anujgite10-10/subthreshold-neuromorphic-lif-stdp/assets/layout_LIF.png

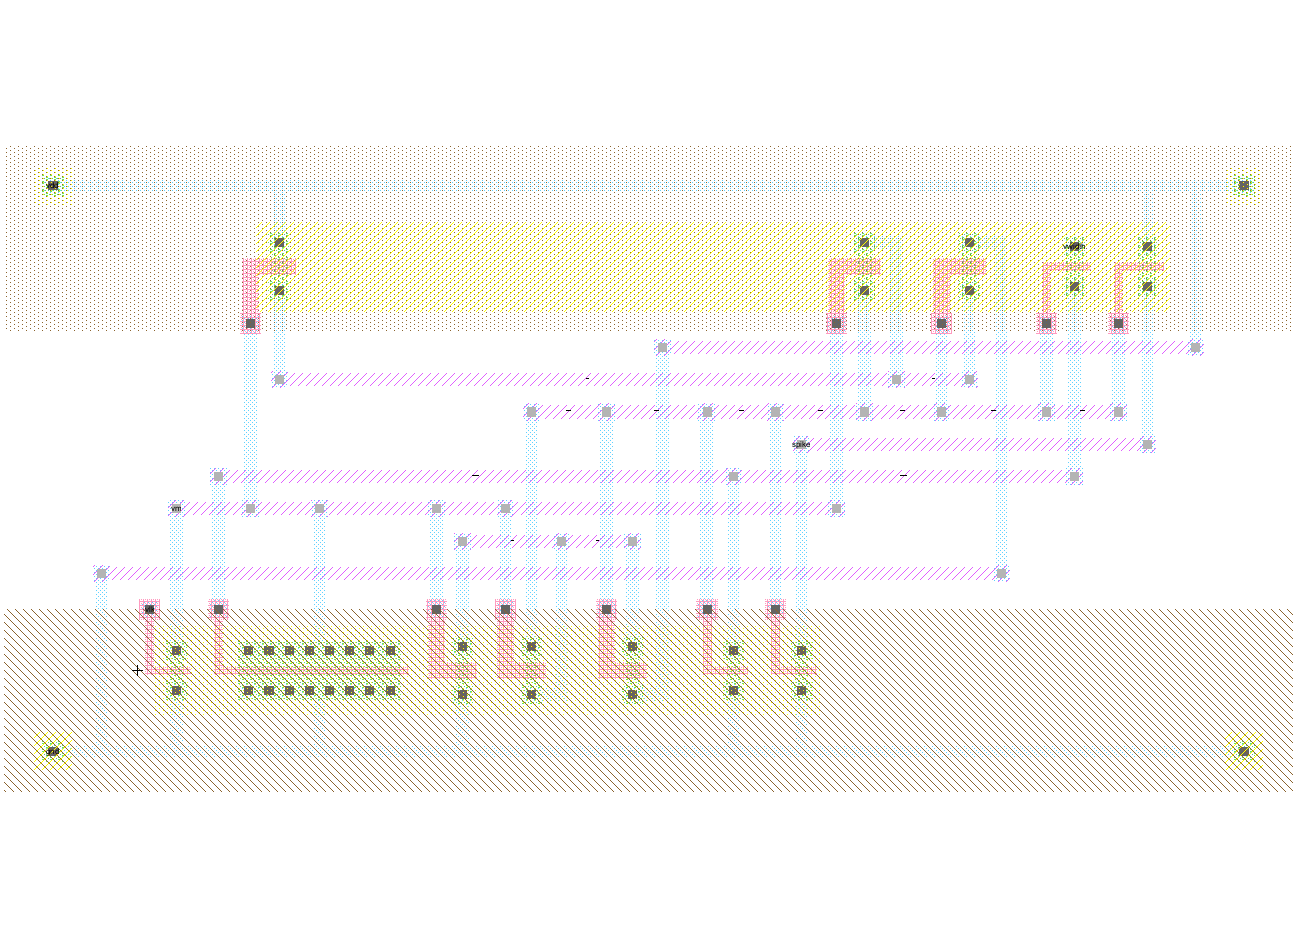
assets/layout_LIF.png
