anujgite10-10/subthreshold-neuromorphic-lif-stdp/assets/layout_OTA.png

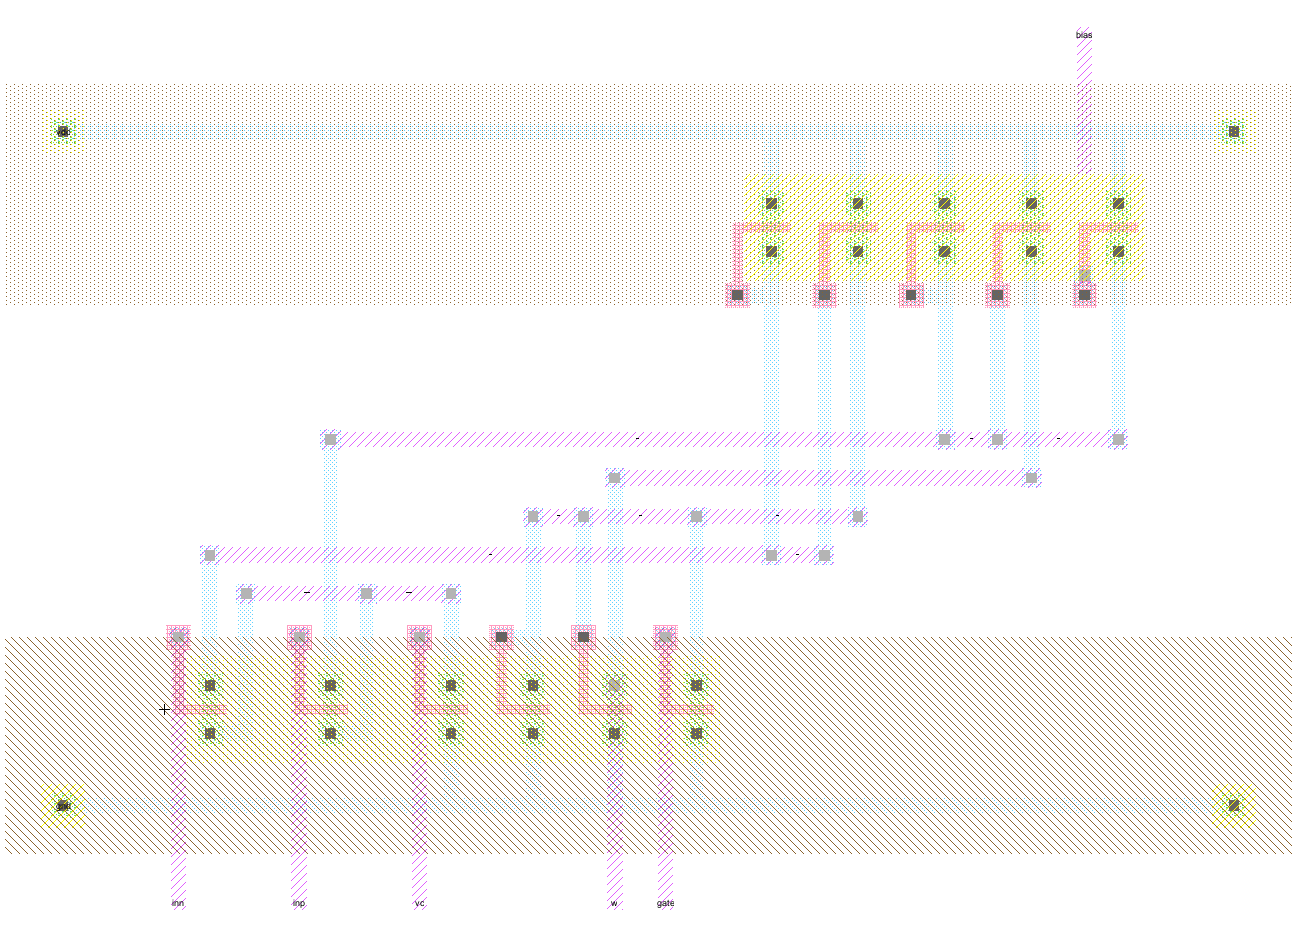
assets/layout_OTA.png
