anujgite10-10/subthreshold-neuromorphic-lif-stdp/assets/layout_STDP.png

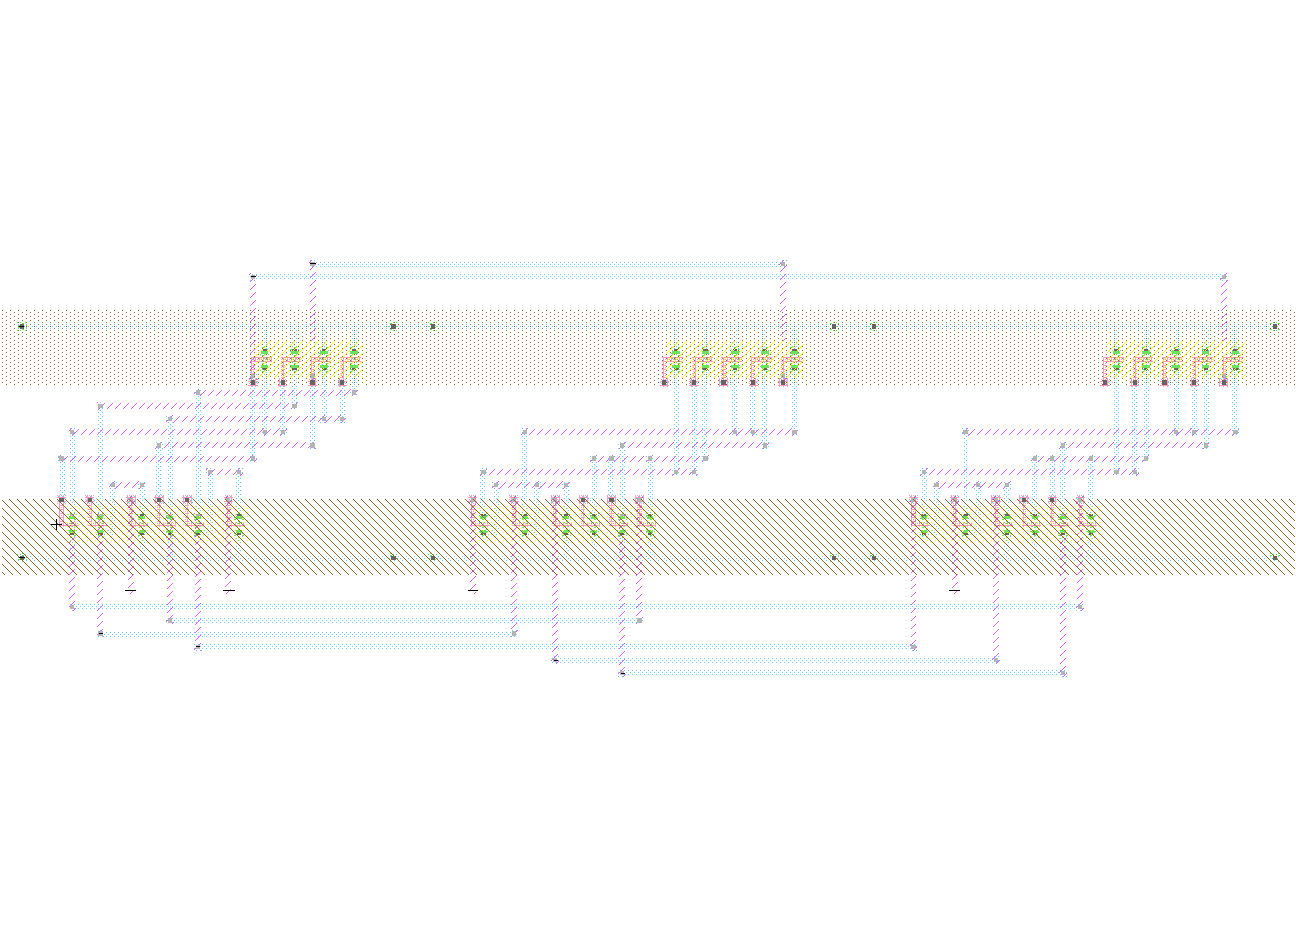
assets/layout_STDP.png
