anujgite10-10/subthreshold-neuromorphic-lif-stdp/assets/layout_TRACE.png

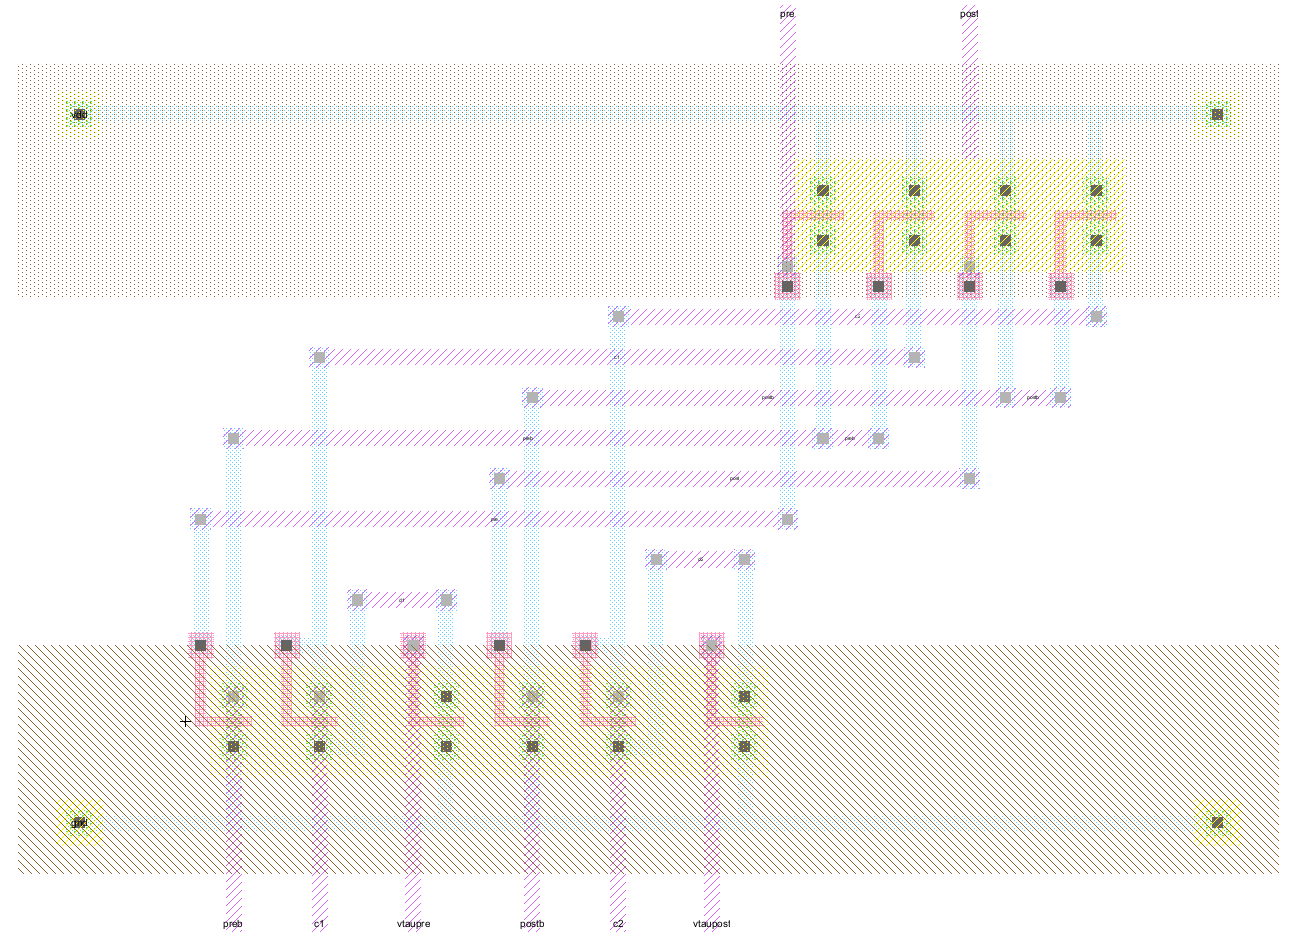
assets/layout_TRACE.png
