anujgite10-10/subthreshold-neuromorphic-lif-stdp/ltspice/01_LIF_baseline/LIF_R1a_fig10_paperVlk.asc

Cm: cap; {CM}
M1: nmos4; NMOS180; l={LN} w={WN}
M2: nmos4; NMOS180; l={LN} w={WN}
MN1: nmos4; NMOS180; l={LN} w={WN}
MN2: nmos4; NMOS180; l={LN} w={WN}
MNF: nmos4; NMOS180; l={LN} w={WN}
MNO: nmos4; NMOS180; l={LN} w={WN}
MNW: nmos4; NMOS180; l={LN} w={WN}
MP1: pmos4; PMOS180; l={LP} w={WP}
MP2: pmos4; PMOS180; l={LP} w={WP}
MPF: pmos4; PMOS180; l={LP} w={WP}
MPO: pmos4; PMOS180; l={LP} w={WP}
MPW: pmos4; PMOS180; l={LP} w={WP}
Rin: res; {RIN}
Vdd: voltage; {VDD}
Vin: voltage; PULSE(0 {VHI} 0.5 1m 1m 1 2)
Vlk: voltage; {VLK}
Vwidth: voltage; {VWIDTH}
Named nets: vdd, 0, vlk, vm, vin, vo, y, spike, x, vrst, vwidth
.include ../../models/180nm_bulk_LTspice_fixed.lib
.param VDD=1 VLK=0.5 VWIDTH=0.9 CM=300n RIN=910k
.param WN=250n LN=200n WP=400n LP=200n
.param VHI=2
.tran 0 6 0 20u
.options plotwinsize=0
.step param VHI list 1.5 2 2.5
