anujgite10-10/subthreshold-neuromorphic-lif-stdp/ltspice/04_STDP/OTA_S0a_test.asc

U1: OTA
Vbias: voltage; {VDD}
Vc: voltage; {VC}
Vdd: voltage; {VDD}
Vgate: voltage; 0
Vinn: voltage; {VINN}
Vinp: voltage; 0
Vout: voltage; {VOUT}
Named nets: w, vdd, vc, inp, inn, gate, bias, 0
.include ../../models/180nm_bulk_LTspice_fixed.lib
.param VDD=1 VINN=0.17 VOUT=0.5 VC=0.6
.param WN=250n LN=200n WP=400n LP=200n
.step param VC list 0.4 0.6 0.8
.dc Vinp 0 1 1m
