anujgite10-10/subthreshold-neuromorphic-lif-stdp/ltspice/02_auditory/LIF_R3_S1_toneburst.asc

Bin: bi; I=pi*IM*burst(time,T0,DUR,TR)*hwr(time,FC)
Cm: cap; {CM}
M1: nmos4; NMOS180; l={LN} w={WN}
M2: nmos4; NMOS180; l={LN} w={WN}
MN1: nmos4; NMOS180; l={LN} w={WN}
MN2: nmos4; NMOS180; l={LN} w={WN}
MNF: nmos4; NMOS180; l={LN} w={WN}
MNO: nmos4; NMOS180; l={LN} w={WN}
MNW: nmos4; NMOS180; l={LN} w={WN}
MP1: pmos4; PMOS180; l={LP} w={WP}
MP2: pmos4; PMOS180; l={LP} w={WP}
MPF: pmos4; PMOS180; l={LP} w={WP}
MPO: pmos4; PMOS180; l={LP} w={WP}
MPW: pmos4; PMOS180; l={LP} w={WP}
Vdd: voltage; {VDD}
Vlk: voltage; {VLK}
Vwidth: voltage; {VWIDTH}
Named nets: vdd, 0, vlk, vm, vo, y, spike, x, vrst, vwidth
.include ../../models/180nm_bulk_LTspice_fixed.lib
.include auditory_stim.inc
.param VDD=1.8 VLK=0.474 VWIDTH=1.62 CM=10n
.param WN=250n LN=200n WP=400n LP=200n
.param IM=3u FC=1k T0=20m DUR=50m TR=5m
.tran 0 120m 0 2u
.options plotwinsize=0
.save V(vm) V(spike) I(Bin) I(Vdd) I(Vwidth)
