anujgite10-10/subthreshold-neuromorphic-lif-stdp/ltspice/03_PartC_optimization/LIF_R6_S1_toneburst.asc

Bin: bi; I=pi*IM*burst(time,T0,DUR,TR)*hwr(time,FC)
Cm: cap; {CM}
M1: nmos4; NMOS180; l={LN} w={WN}
M2: nmos4; NMOS180; l={LN} w={WM2}
MN1: nmos4; NMOS180; l={LSN} w={WN}
MN2: nmos4; NMOS180; l={LSN} w={WN}
MNF: nmos4; NMOS180; l={LSN} w={WN}
MNO: nmos4; NMOS180; l={LN} w={WN}
MNW: nmos4; NMOS180; l={LN} w={WN}
MP1: pmos4; PMOS180; l={LSP} w={WP}
MP2: pmos4; PMOS180; l={LSP} w={WP}
MPF: pmos4; PMOS180; l={LSP} w={WP}
MPO: pmos4; PMOS180; l={LP} w={WP}
MPW: pmos4; PMOS180; l={LP} w={WP}
Vdd: voltage; {VDD}
Vlk: voltage; {VLK}
Vwidth: voltage; {VWIDTH}
Named nets: vdd, 0, vlk, vm, vo, y, spike, x, vrst, vwidth
.include ../../models/180nm_bulk_LTspice_fixed.lib
.include ../02_auditory/auditory_stim.inc
.param VDD=0.6 VLK=0.518 VWIDTH=0.6 CM=25.3n
.param LSN=400n LSP=400n WM2=4u
.param WN=250n LN=200n WP=400n LP=200n
.param IM=3u FC=1k T0=20m DUR=50m TR=5m
.tran 0 120m 0 2u
.options plotwinsize=0
.save V(vm) V(spike) I(Bin) I(Vdd) I(Vwidth)
