anujgite10-10/subthreshold-neuromorphic-lif-stdp/ltspice/04_STDP/STDP_R1a_fig14.asc

C1: cap; {C1}
C2: cap; {C2}
Cw: cap; {CW}
M1: pmos4; PMOS180; l={LP} w={WP}
M1N1: nmos4; NMOS180; l={LN} w={WN}
M1P1: pmos4; PMOS180; l={LP} w={WP}
M2: nmos4; NMOS180; l={LN} w={WN}
M3: pmos4; PMOS180; l={LP} w={WP}
M4: nmos4; NMOS180; l={LN} w={WN}
MD1: nmos4; NMOS180; l={LN} w={WN}
MD2: nmos4; NMOS180; l={LN} w={WN}
MIN2: nmos4; NMOS180; l={LN} w={WN}
MIP2: pmos4; PMOS180; l={LP} w={WP}
U1: OTA
U2: OTA
Vc: voltage; {VC}
Vdd: voltage; {VDD}
Vpost: voltage; PULSE(0 {VDD} 200m 10u 10u 1m 10)
Vpre: voltage; PULSE(0 {VDD} {200m+DT} 10u 10u 1m 10)
Vrefpost: voltage; {VREFPOST}
Vrefpre: voltage; {VREFPRE}
Vtaupost: voltage; {VTAUPOST}
Vtaupre: voltage; {VTAUPRE}
Named nets: 0, pre, preb, vdd, c1, d1, vtaupre, vrefpre, post, postb, vc, vw, c2, d2, vtaupost, vrefpost
.include ../../models/180nm_bulk_LTspice_fixed.lib
.param VDD=1 VTAUPRE=0.25 VTAUPOST=0.25 VREFPRE=0.17 VREFPOST=0.17 VC=0.7
.param C1=2.2n C2=2.2n CW=100n VW0=0.95
.param WN=250n LN=200n WP=400n LP=200n
.param DT=-12m
.ic V(vw)={VW0}
.step param DT list -150m -100m -60m -40m -20m -12m -2m 2m 7m 10m 20m 30m 40m 50m
.tran 0 270m 0 20u
.options plotwinsize=0
