anujgite10-10/subthreshold-neuromorphic-lif-stdp/ltspice/04_STDP/STDP_R1b_fig13.asc

C1: cap; {C1}
C2: cap; {C2}
Cw: cap; {CW}
M1: pmos4; PMOS180; l={LP} w={WP}
M1N1: nmos4; NMOS180; l={LN} w={WN}
M1P1: pmos4; PMOS180; l={LP} w={WP}
M2: nmos4; NMOS180; l={LN} w={WN}
M3: pmos4; PMOS180; l={LP} w={WP}
M4: nmos4; NMOS180; l={LN} w={WN}
MD1: nmos4; NMOS180; l={LN} w={WN}
MD2: nmos4; NMOS180; l={LN} w={WN}
MIN2: nmos4; NMOS180; l={LN} w={WN}
MIP2: pmos4; PMOS180; l={LP} w={WP}
U1: OTA
U2: OTA
Vc: voltage; {VC}
Vdd: voltage; {VDD}
Vpost: voltage; PWL(0 0 0.01974 0 0.01975 {VDD} 0.02075 {VDD} 0.02076 0 0.03972 0 0.03973 {VDD} 0.04073 {VDD} 0.04074 0 0.0598 0 0.05981 {VDD} 0.06081 {VDD} 0.06082 0 0.08028 0 0.08029 {VDD} 0.08129 {VDD} 0.0813 0)
Vpre: voltage; PWL(0 0 0.02024 0 0.02025 {VDD} 0.02125 {VDD} 0.02126 0 0.07029 0 0.0703 {VDD} 0.0713 {VDD} 0.07131 0)
Vrefpost: voltage; {VREFPOST}
Vrefpre: voltage; {VREFPRE}
Vtaupost: voltage; {VTAUPOST}
Vtaupre: voltage; {VTAUPRE}
Named nets: 0, pre, preb, vdd, c1, d1, vtaupre, vrefpre, post, postb, vc, vw, c2, d2, vtaupost, vrefpost
.include ../../models/180nm_bulk_LTspice_fixed.lib
.param VDD=1 VTAUPRE=0.290 VTAUPOST=0.320 VREFPRE=0.17 VREFPOST=0.17 VC=0.7
.param C1=2.2n C2=2.2n CW=30n VW0=0.95
.param WN=250n LN=200n WP=400n LP=200n
.ic V(vw)=0.969
.tran 0 100m 0 5u
.options plotwinsize=0
