anujgite10-10/subthreshold-neuromorphic-lif-stdp/ltspice/06_PartB/65nm/LIF_B65_S1_toneburst.asc

Bin: bi; I=pi*IM*burst(time,T0,DUR,TR)*hwr(time,FC)
Cm: cap; {CM}
M1: nmos4; NMOS65; l={LN} w={WN}
M2: nmos4; NMOS65; l={LN} w={WM2}
MN1: nmos4; NMOS65; l={LSN} w={WN}
MN2: nmos4; NMOS65; l={LSN} w={WN}
MNF: nmos4; NMOS65; l={LSN} w={WN}
MNO: nmos4; NMOS65; l={LN} w={WN}
MNW: nmos4; NMOS65; l={LN} w={WN}
MP1: pmos4; PMOS65; l={LSP} w={WP}
MP2: pmos4; PMOS65; l={LSP} w={WP}
MPF: pmos4; PMOS65; l={LSP} w={WP}
MPO: pmos4; PMOS65; l={LP} w={WP}
MPW: pmos4; PMOS65; l={LP} w={WP}
Vdd: voltage; {VDD}
Vlk: voltage; {VLK}
Vwidth: voltage; {VWIDTH}
Named nets: vdd, 0, vlk, vm, vo, y, spike, x, vrst, vwidth
.include ../../../models/ptm/ptm65_LTspice.lib
.include ../../02_auditory/auditory_stim.inc
.param VDD=1.1 VLK=0.36 VWIDTH={0.9*VDD} CM=15n
.param WM2=90n LSN={LN} LSP={LP}
.param WN=90n LN=72n WP=144n LP=72n
.param IM=3u FC=1k T0=20m DUR=50m TR=5m
.tran 0 120m 0 2u
.options plotwinsize=0
.save V(vm) V(spike) I(Bin) I(Vdd) I(Vwidth)
