anujgite10-10/subthreshold-neuromorphic-lif-stdp/ltspice/06_PartB/65nm/OTA.asc

M1: pmos4; PMOS65; l={LP} w={WP}
M2: pmos4; PMOS65; l={LP} w={WP}
M3: pmos4; PMOS65; l={LP} w={WP}
M4: pmos4; PMOS65; l={LP} w={WP}
M5: pmos4; PMOS65; l={LP} w={WP}
M6: nmos4; NMOS65; l={LN} w={WN}
M7: nmos4; NMOS65; l={LN} w={WN}
M8: nmos4; NMOS65; l={LN} w={WN}
M9: nmos4; NMOS65; l={LN} w={WN}
M10: nmos4; NMOS65; l={LN} w={WN}
M11: nmos4; NMOS65; l={LN} w={WN}
Named nets: 0, vdd, a, b, tail, gate, c, inn, vc, inp, bias, w
