anujgite10-10/subthreshold-neuromorphic-lif-stdp/ltspice/06_PartB/65nm/STDP_B65_fig14.asc

C1: cap; {C1}
C2: cap; {C2}
Cw: cap; {CW}
M1: pmos4; PMOS65; l={LP} w={WP}
M1N1: nmos4; NMOS65; l={LN} w={WN}
M1P1: pmos4; PMOS65; l={LP} w={WP}
M2: nmos4; NMOS65; l={LN} w={WN}
M3: pmos4; PMOS65; l={LP} w={WP}
M4: nmos4; NMOS65; l={LN} w={WN}
MD1: nmos4; NMOS65; l={LN} w={WN}
MD2: nmos4; NMOS65; l={LN} w={WN}
MIN2: nmos4; NMOS65; l={LN} w={WN}
MIP2: pmos4; PMOS65; l={LP} w={WP}
U1: OTA
U2: OTA
Vc: voltage; {VC}
Vdd: voltage; {VDD}
Vpost: voltage; PULSE(0 {VDD} 200m 10u 10u 1m 10)
Vpre: voltage; PULSE(0 {VDD} {200m+DT} 10u 10u 1m 10)
Vrefpost: voltage; {VREFPOST}
Vrefpre: voltage; {VREFPRE}
Vtaupost: voltage; {VTAUPOST}
Vtaupre: voltage; {VTAUPRE}
Named nets: 0, pre, preb, vdd, c1, d1, vtaupre, vrefpre, post, postb, vc, vw, c2, d2, vtaupost, vrefpost
.include ../../../models/ptm/ptm65_LTspice.lib
.param VDD=1.1 VTAUPRE=0.155 VTAUPOST=0.207 VREFPRE=0.10 VREFPOST=0.10 VC=0.46
.param C1=2.2n C2=2.2n CW=30n VW0=1.045 VT=0.3
.param WN=90n LN=72n WP=144n LP=72n
.param DT=-12m
.ic V(vw)={VW0}
.step param DT list -150m -140m -130m -120m -110m -100m -90m -80m -70m -60m -50m -40m -30m -20m -15m -12m -10m -8m -6m -4m -2m 2m 4m 7m 10m 13m 16m 20m 25m 30m 35m 40m 45m 50m 55m 60m
.tran 0 270m 0 20u
.options plotwinsize=0
