anujgite10-10/subthreshold-neuromorphic-lif-stdp/ltspice/06_PartB/90nm/LIF_B90_fig10.asc

Cm: cap; {CM}
M1: nmos4; NMOS90; l={LN} w={WN}
M2: nmos4; NMOS90; l={LN} w={WN}
MN1: nmos4; NMOS90; l={LN} w={WN}
MN2: nmos4; NMOS90; l={LN} w={WN}
MNF: nmos4; NMOS90; l={LN} w={WN}
MNO: nmos4; NMOS90; l={LN} w={WN}
MNW: nmos4; NMOS90; l={LN} w={WN}
MP1: pmos4; PMOS90; l={LP} w={WP}
MP2: pmos4; PMOS90; l={LP} w={WP}
MPF: pmos4; PMOS90; l={LP} w={WP}
MPO: pmos4; PMOS90; l={LP} w={WP}
MPW: pmos4; PMOS90; l={LP} w={WP}
Rin: res; {RIN}
Vdd: voltage; {VDD}
Vin: voltage; PULSE(0 {VHI} 0.5 1m 1m 1 2)
Vlk: voltage; {VLK}
Vwidth: voltage; {VWIDTH}
Named nets: vdd, 0, vlk, vm, vin, vo, y, spike, x, vrst, vwidth
.include ../../../models/ptm/ptm90_LTspice.lib
.param VDD=1.2 VLK=0.313 VWIDTH={0.9*VDD} CM=300n RIN=910k
.param WN=125n LN=100n WP=200n LP=100n
.param VHI=2.4
.step param VHI list 1.8 2.4 3
.tran 0 6 0 20u
.options plotwinsize=0
